jpsmithnl/arbot/hardware/eagle_projects/arduino_irobot_bridge/doc/arduino_irobot_bridge.brd.png

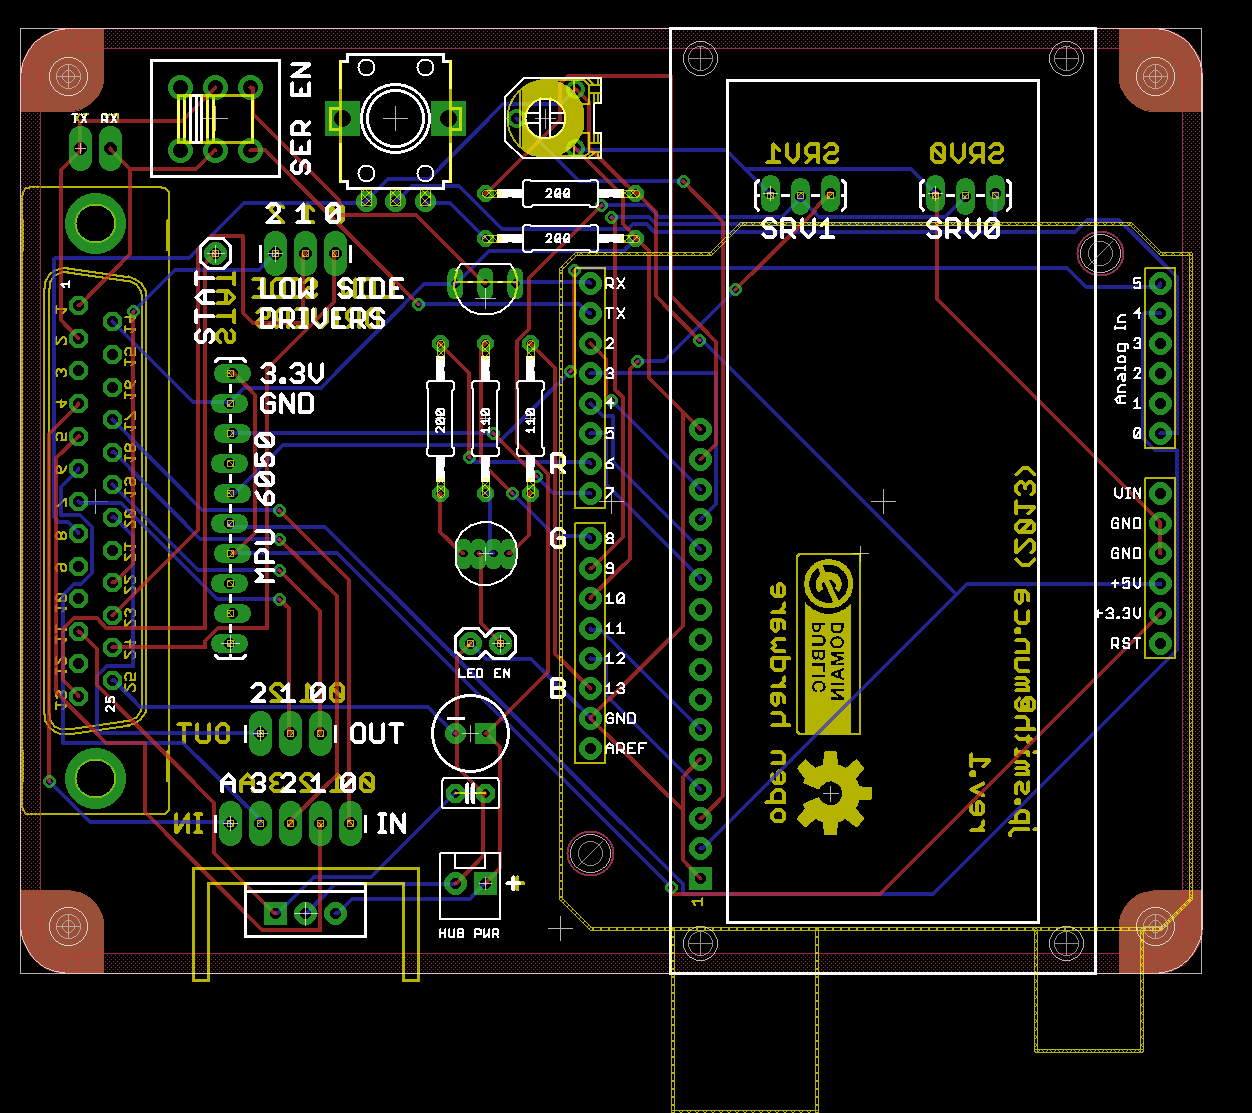
hardware/eagle_projects/arduino_irobot_bridge/doc/arduino_irobot_bridge.brd.png
