jpsmithnl/arbot/hardware/eagle_projects/arduino_irobot_bridge/doc/arduino_irobot_bridge.sch.png

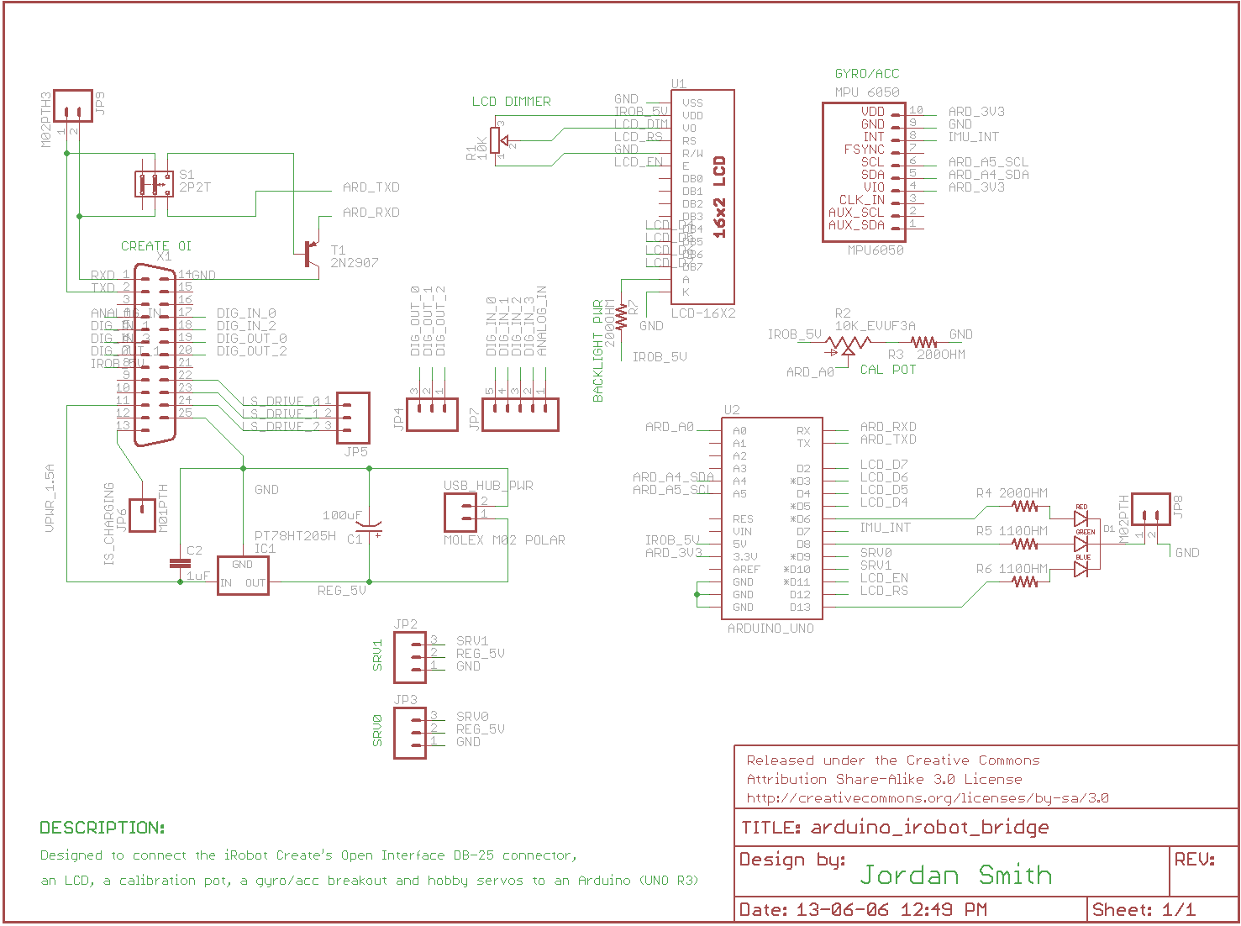
hardware/eagle_projects/arduino_irobot_bridge/doc/arduino_irobot_bridge.sch.png
