jpsmithnl/arbot/hardware/eagle_projects/arduino_irobot_bridge/arduino_irobot_bridge_rev1/arduino_irobot_bridge.brd

## EAGLE design hardware/eagle_projects/arduino_irobot_bridge/arduino_irobot_bridge_rev1/arduino_irobot_bridge.brd (2015-03-20)

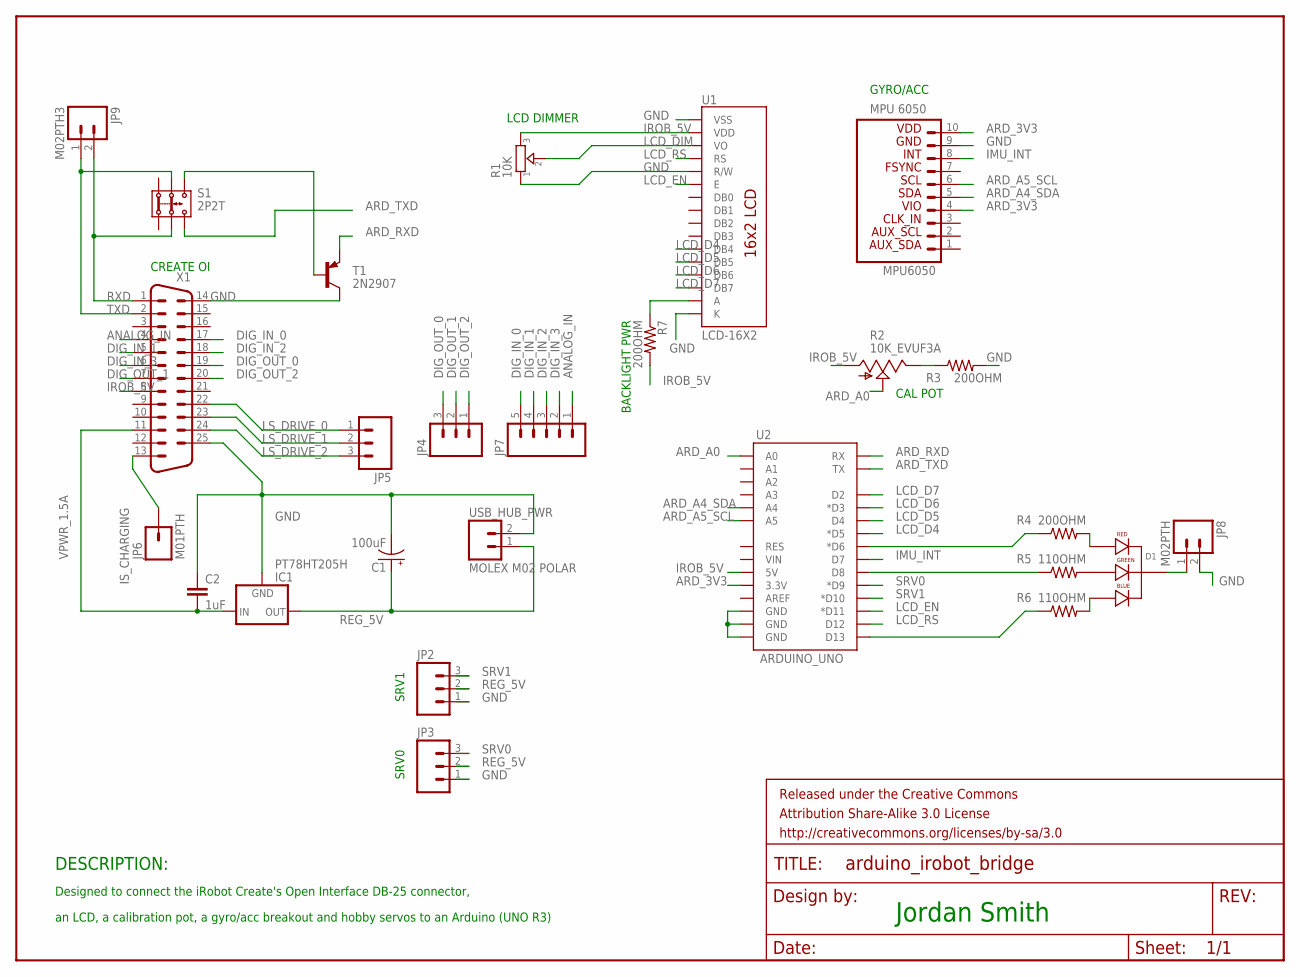
[picture p3: schematic arduino_irobot_bridge.sch]

Parts:
C1: 100uF; CPOL-RADIAL-100UF-25V
C2: 1uF; C2.5-2
D1: LED-RGB-CC-THRUCLEAR; LED-RGB-THRU
FRAME1: FRAME-LETTER; CREATIVE_COMMONS
IC1: PT78HT205H; TO220-IGO
JP1: MPU6050; 1X10_LOCK_LONGPADS
JP2, JP3: M03LOCK_LONGPADS; 1X03_LOCK_LONGPADS
JP4, JP5: M03LONGPADS; 1X03_LONGPADS
JP6: M01PTH; 1X01
JP7: M05PTH_LONGPADS; 1X05_LONGPADS
JP8: M02PTH; 1X02
JP9: M02PTH3; 1X02_LONGPADS
R1: 10K; TRIMMER_3306F
R2: 10K_EVUF3A; EVUF
R3, R4, R7: 200OHM; 0207/12
R5, R6: 110OHM; 0207/12
S1: 2P2T
T1: 2N2907; TO92-EBC
U1: LCD-16X2
U2: ARDUINO_UNO; DUEMILANOVE_SHIELD
USB_HUB_PWR: MOLEX M02 POLAR; MOLEX-1X2
X1: DB25VP; M25VP

Connections:
ANALOG_IN: JP7.1, X1.4
ARD_3V3: JP1.4 (VIO), JP1.10 (VDD_3V3), U2.3.3V
ARD_A0: R2.2 (S), U2.A0
ARD_A4_SDA: JP1.5 (SDA), U2.A4
ARD_A5_SCL: JP1.6 (SCL), U2.A5
ARD_RXD: T1.E, U2.RX
ARD_TXD: S1.3.2, U2.TX
DIG_IN_0: JP7.5, X1.17
DIG_IN_1: JP7.4, X1.5
DIG_IN_2: JP7.3, X1.18
DIG_IN_3: JP7.2, X1.6
DIG_OUT_0: JP4.3, X1.19
DIG_OUT_1: JP4.2, X1.7
DIG_OUT_2: JP4.1, X1.20
GND: C1.2 (-), C2.1, IC1.GND, JP1.9 (GND), JP2.1, JP3.1, JP8.2, R1.1, R3.2, T1.C, U1.1 (VSS), U1.5 (R/W), U1.16 (K), U2.GND@0 (GND), U2.GND@1 (GND), U2.GND@2 (GND), USB_HUB_PWR.2, X1.14, X1.25
IMU_INT: JP1.8 (INT), U2.D7
IROB_5V: R1.3, R2.1 (A), R7.2, U1.2 (VDD), U2.5V, X1.8
IS_CHARGING: JP6.1, X1.13
LCD_D4: U1.11 (DB4), U2.D5 (*D5)
LCD_D5: U1.12 (DB5), U2.D4
LCD_D6: U1.13 (DB6), U2.D3 (*D3)
LCD_D7: U1.14 (DB7), U2.D2
LCD_DIM: R1.2, U1.3 (VO)
LCD_EN: U1.6 (E), U2.D11 (*D11)
LCD_RS: U1.4 (RS), U2.D12
LS_DRIVE_0: JP5.1, X1.22
LS_DRIVE_1: JP5.2, X1.23
LS_DRIVE_2: JP5.3, X1.24
unnamed: R7.1, U1.15 (A)
unnamed: R2.3 (E), R3.1
unnamed: D1.1 (RED_CATHODE), R4.2
unnamed: D1.3 (GREEN_CATHODE), R5.2
unnamed: D1.4 (BLUE_CATHODE), R6.2
unnamed: S1.3.1, T1.B
unnamed: D1.2 (CATHODE), JP8.1
unnamed: R4.1, U2.D6 (*D6)
unnamed: R5.1, U2.D8
unnamed: R6.1, U2.D13
REG_5V: C1.1 (+), IC1.OUT, JP2.2, JP3.2, USB_HUB_PWR.1
RXD: JP9.2, S1.2.2, X1.1
SRV0: JP3.3, U2.D9 (*D9)
SRV1: JP2.3, U2.D10 (*D10)
TXD: JP9.1, S1.2.1, X1.2
VPWR_1.5A: C2.2, IC1.IN, X1.11

Notes on the sheet:
Jordan Smith
Designed to connect the iRobot Create's Open Interface DB-25 connector,
an LCD, a calibration pot, a gyro/acc breakout and hobby servos to an Arduino (UNO R3)
DESCRIPTION:
GYRO/ACC
CAL POT
LCD DIMMER
SRV1
SRV0
CREATE OI
BACKLIGHT PWR

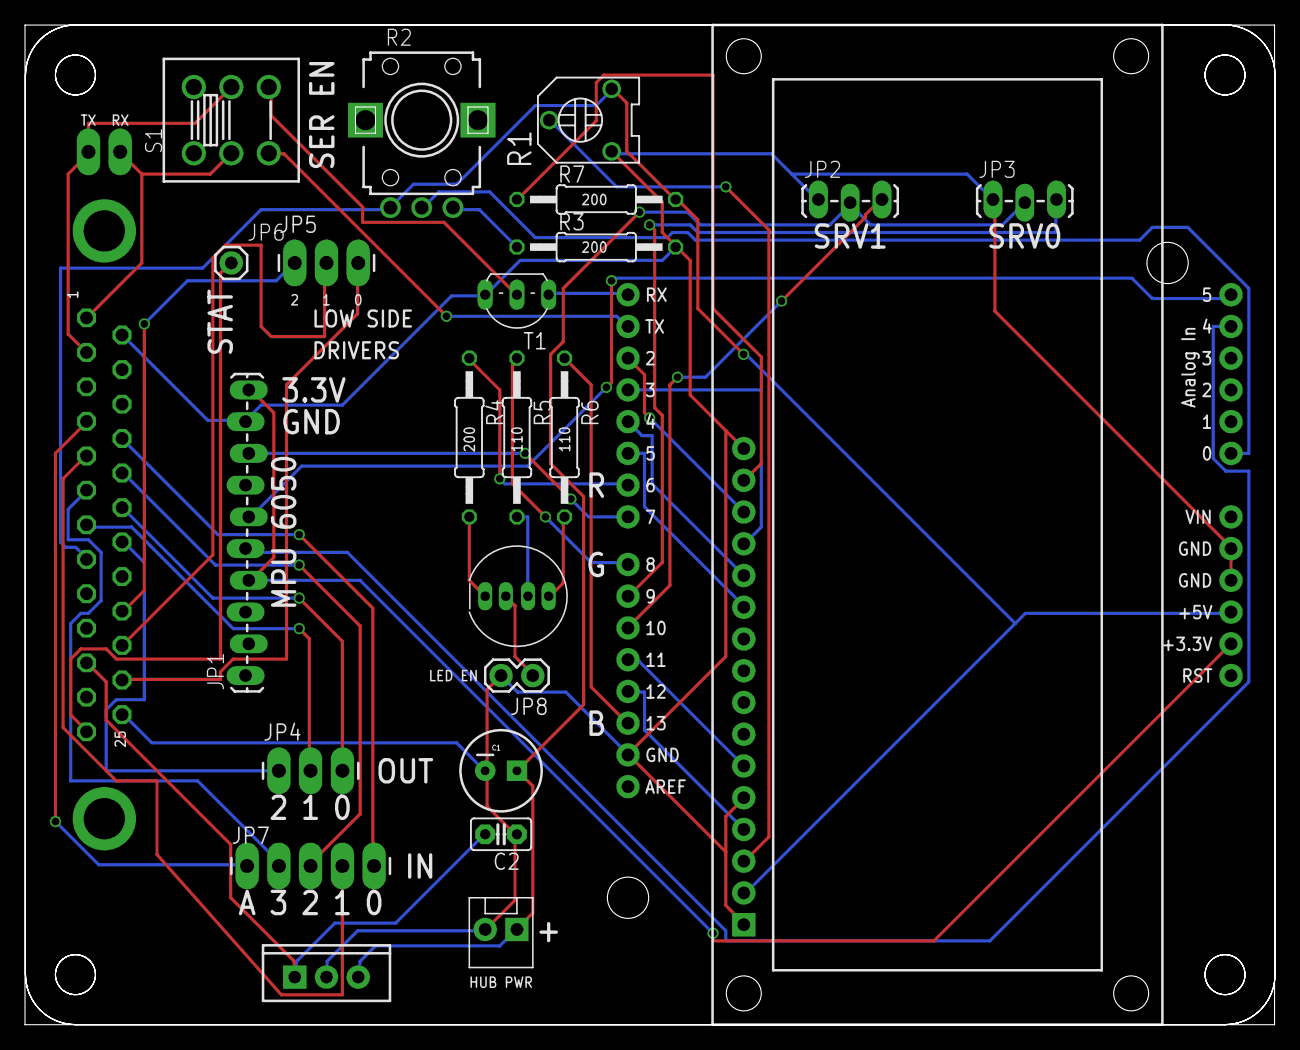
[picture p4: board arduino_irobot_bridge.brd from above]

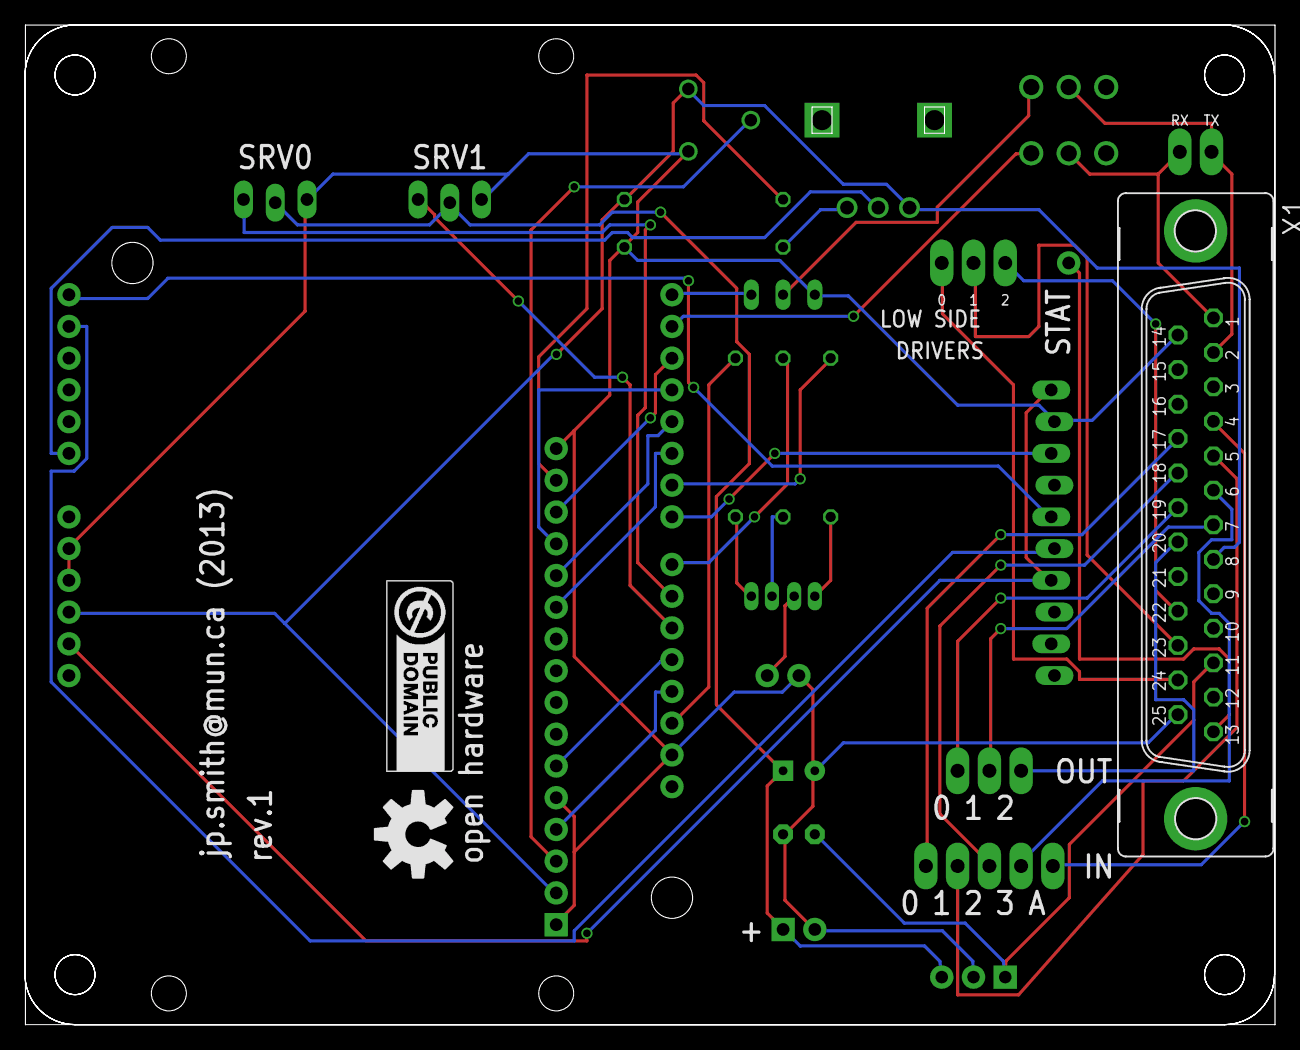
[picture p5: board arduino_irobot_bridge.brd from below]

Board: 4 copper layers, 100.0 x 80.0 mm, 32 parts (3 on the bottom side), 44 nets.

Other parts of the board:
U$1, U$2, U$3: DP10080_V1
U$4: OSHW-LOGO-L
U$5: LOGO_CC-0
